joshajohnson/voyager-logic/README.md

# Voyager Logic

A FX3 based logic analyser capable of 16 channels at 100 MSPS.
