joshajohnson/voyager-logic/hardware/0.1/voyager-logic.kicad_pcb

## KiCad design hardware/0.1/voyager-logic.kicad_pcb (2022-12-25)

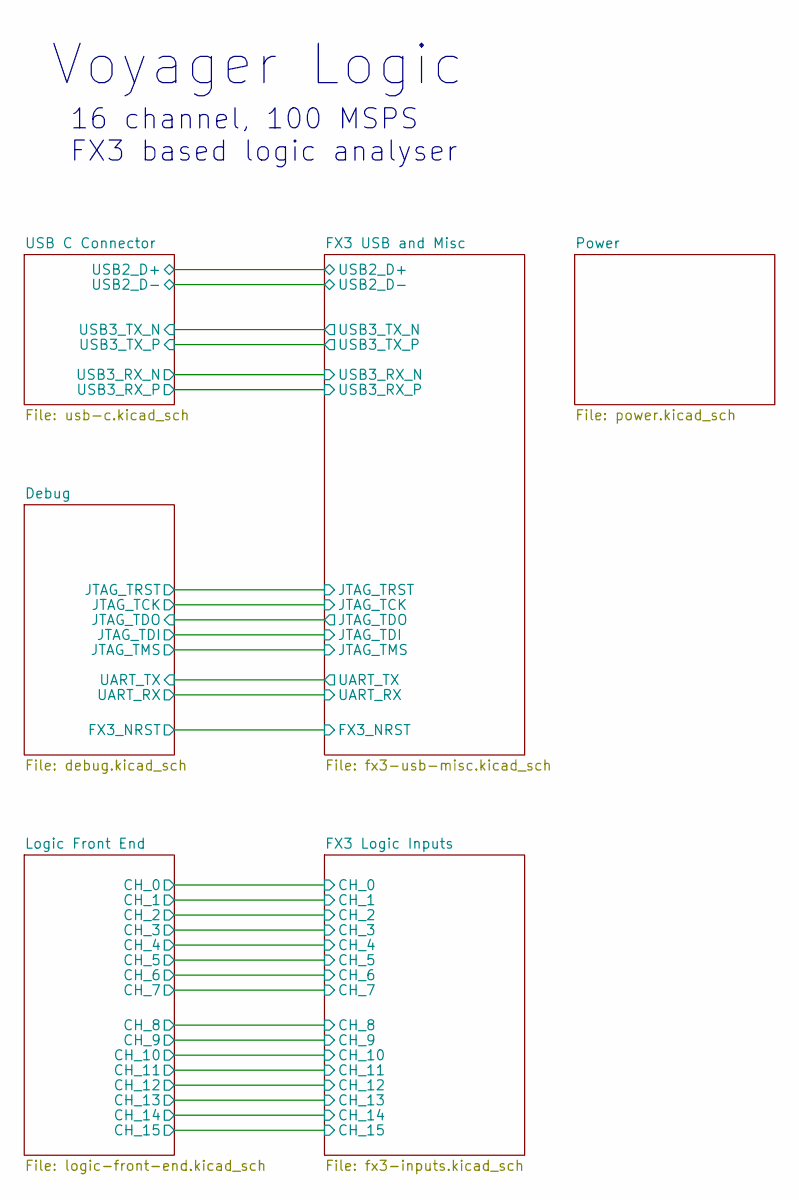
[picture p1: schematic voyager-logic.kicad_sch, Voyager Logic]

Notes on the sheet:
16 channel, 100 MSPS FX3 based logic analyser
Voyager Logic

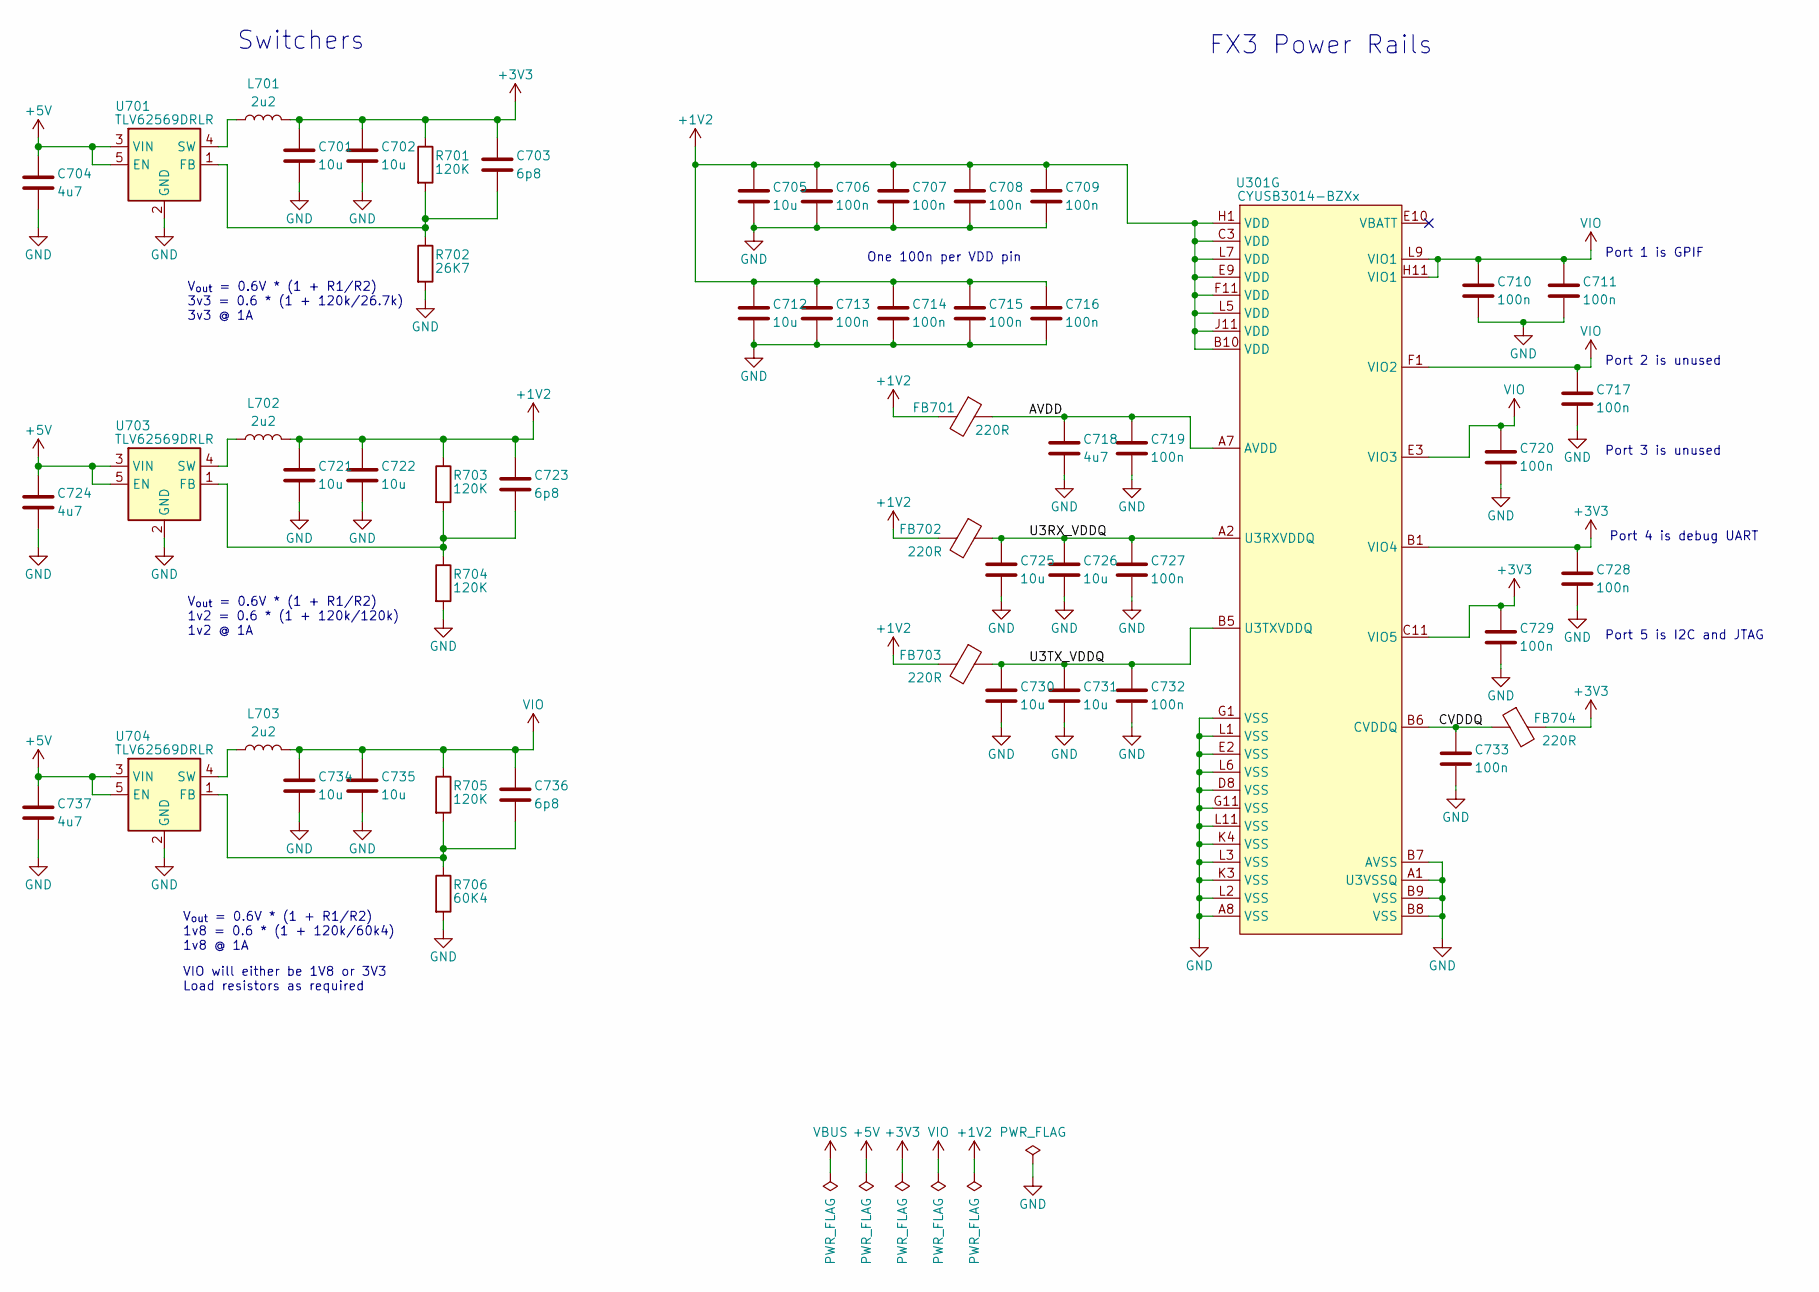
[picture p2: schematic power.kicad_sch, Voyager Logic]

Parts:
C701, C702, C705, C712, C721, C722, C725, C726, C730, C731, C734, C735: 10u; C_0603_1608Metric; MPN CL10A106MA8NRNC; LCSC C96446
C703, C723, C736: 6p8; C_0402_1005Metric; MPN GJM1555C1H6R8BB01D; LCSC C88896
C704, C718, C724, C737: 4u7; C_0402_1005Metric; MPN CL05A475MP5NRNC; LCSC C23733
C706, C707, C708, C709, C710, C711, C713, C714, C715, C716, C717, C719, C720, C727, C728, C729, C732, C733: 100n; C_0402_1005Metric; MPN CL05B104KB54PNC; LCSC C307331
FB701, FB702, FB703, FB704: 220R; R_0402_1005Metric; MPN BLM15PX221SN1D; LCSC C160973
L701, L702, L703: 2u2; L_0805_2012Metric; MPN LQM21PN2R2NGCD; LCSC C216156
R701, R703, R704, R705: 120K; R_0402_1005Metric; MPN RC0402FR-07120KL; LCSC C93945
R702: 26K7; R_0402_1005Metric; MPN RC0402FR-0726K7L; LCSC C138023
R706: 60K4; R_0402_1005Metric; MPN RC0402FR-0760K4L; LCSC C327333
U301: CYUSB3014-BZXx; BGA-121_10x10mm_Layout11x11_P0.8mm; MPN CYUSB3014-BZXC; LCSC C462526
U701, U703, U704: TLV62569DRLR; SOT-563; MPN TLV62569DRLR; LCSC C163217

Connections:
+1V2: C705.1, C706.1, C707.1, C708.1, C709.1, C712.1, C713.1, C714.1, C715.1, C716.1, C721.1, C722.1, C723.1, FB701.2, FB702.2, FB703.2, L702.2, R703.1, U301.B10 (VDD), U301.C3 (VDD), U301.E9 (VDD), U301.F11 (VDD), U301.H1 (VDD), U301.J11 (VDD), U301.L5 (VDD), U301.L7 (VDD)
+3V3: C701.1, C702.1, C703.1, C728.1, C729.1, FB704.2, L701.2, R701.1, U301.B1 (VIO4), U301.C11 (VIO5); also elsewhere on the board
+5V: C704.1, C724.1, C737.1, U701.3 (VIN), U701.5 (EN), U703.3 (VIN), U703.5 (EN), U704.3 (VIN), U704.5 (EN); also elsewhere on the board
/Power/AVDD: C718.1, C719.1, FB701.1, U301.A7 (AVDD)
/Power/CVDDQ: C733.1, FB704.1, U301.B6 (CVDDQ)
/Power/U3RX_VDDQ: C725.1, C726.1, C727.1, FB702.1, U301.A2 (U3RXVDDQ)
/Power/U3TX_VDDQ: C730.1, C731.1, C732.1, FB703.1, U301.B5 (U3TXVDDQ)
GND: C701.2, C702.2, C704.2, C705.2, C706.2, C707.2, C708.2, C709.2, C710.2, C711.2, C712.2, C713.2, C714.2, C715.2, C716.2, C717.2, C718.2, C719.2, C720.2, C721.2, C722.2, C724.2, C725.2, C726.2, C727.2, C728.2, C729.2, C730.2, C731.2, C732.2, C733.2, C734.2, C735.2, C737.2, R702.2, R704.2, R706.2, U301.A1 (U3VSSQ), U301.A8 (VSS), U301.B7 (AVSS), U301.B8 (VSS), U301.B9 (VSS), U301.D8 (VSS), U301.E2 (VSS), U301.G1 (VSS), U301.G11 (VSS), U301.K3 (VSS), U301.K4 (VSS), U301.L1 (VSS), U301.L2 (VSS), U301.L3 (VSS), U301.L6 (VSS), U301.L11 (VSS), U701.2 (GND), U703.2 (GND), U704.2 (GND); also elsewhere on the board
unnamed: C703.2, R701.2, R702.1, U701.1 (FB)
unnamed: C723.2, R703.2, R704.1, U703.1 (FB)
unnamed: C736.2, R705.2, R706.1, U704.1 (FB)
unnamed: L701.1, U701.4 (SW)
unnamed: L702.1, U703.4 (SW)
unnamed: L703.1, U704.4 (SW)
VIO: C710.1, C711.1, C717.1, C720.1, C734.1, C735.1, C736.1, L703.2, R705.1, U301.E3 (VIO3), U301.F1 (VIO2), U301.H11 (VIO1), U301.L9 (VIO1); also elsewhere on the board

Notes on the sheet:
V_{out} = 0.6V * (1 + R1/R2) 3v3 = 0.6 * (1 + 120k/26.7k) 3v3 @ 1A
V_{out} = 0.6V * (1 + R1/R2) 1v8 = 0.6 * (1 + 120k/60k4) 1v8 @ 1A
Switchers
FX3 Power Rails
Port 2 is unused
Port 4 is debug UART
One 100n per VDD pin
Port 3 is unused
V_{out} = 0.6V * (1 + R1/R2) 1v2 = 0.6 * (1 + 120k/120k) 1v2 @ 1A
Port 1 is GPIF
Port 5 is I2C and JTAG
VIO will either be 1V8 or 3V3 Load resistors as required

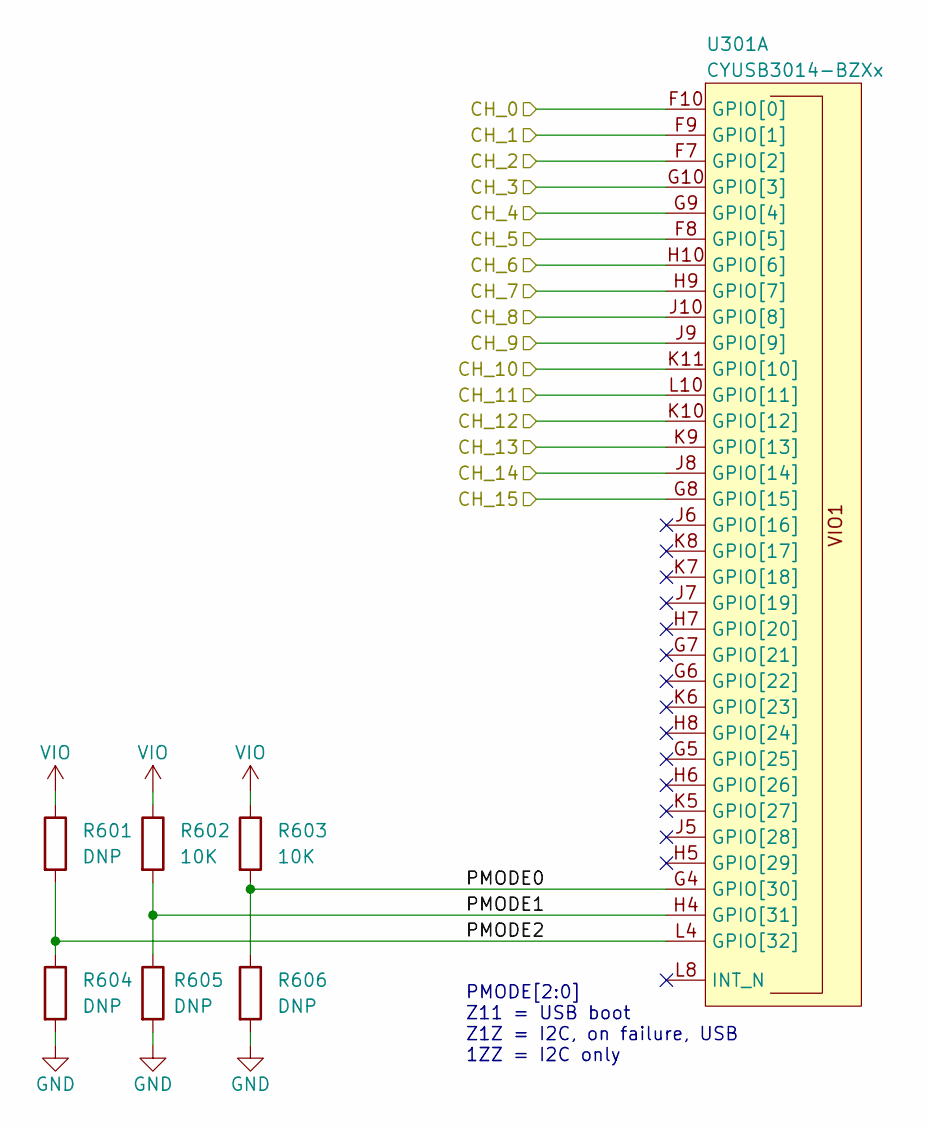
[picture p3: schematic fx3-inputs.kicad_sch, Voyager Logic]

Parts:
R601, R604, R605, R606: DNP; R_0402_1005Metric
R602, R603: 10K; R_0402_1005Metric; MPN RC0402FR-0710KL; LCSC C60490
U301: CYUSB3014-BZXx; BGA-121_10x10mm_Layout11x11_P0.8mm; MPN CYUSB3014-BZXC; LCSC C462526

Connections:
/FX3 Logic Inputs/CH_0: U301.F10 (GPIO[0]); also elsewhere on the board
/FX3 Logic Inputs/CH_1: U301.F9 (GPIO[1]); also elsewhere on the board
/FX3 Logic Inputs/CH_2: U301.F7 (GPIO[2]); also elsewhere on the board
/FX3 Logic Inputs/CH_3: U301.G10 (GPIO[3]); also elsewhere on the board
/FX3 Logic Inputs/CH_4: U301.G9 (GPIO[4]); also elsewhere on the board
/FX3 Logic Inputs/CH_5: U301.F8 (GPIO[5]); also elsewhere on the board
/FX3 Logic Inputs/CH_6: U301.H10 (GPIO[6]); also elsewhere on the board
/FX3 Logic Inputs/CH_7: U301.H9 (GPIO[7]); also elsewhere on the board
/FX3 Logic Inputs/CH_8: U301.J10 (GPIO[8]); also elsewhere on the board
/FX3 Logic Inputs/CH_9: U301.J9 (GPIO[9]); also elsewhere on the board
/FX3 Logic Inputs/CH_10: U301.K11 (GPIO[10]); also elsewhere on the board
/FX3 Logic Inputs/CH_11: U301.L10 (GPIO[11]); also elsewhere on the board
/FX3 Logic Inputs/CH_12: U301.K10 (GPIO[12]); also elsewhere on the board
/FX3 Logic Inputs/CH_13: U301.K9 (GPIO[13]); also elsewhere on the board
/FX3 Logic Inputs/CH_14: U301.J8 (GPIO[14]); also elsewhere on the board
/FX3 Logic Inputs/CH_15: U301.G8 (GPIO[15]); also elsewhere on the board
/FX3 Logic Inputs/PMODE0: R603.2, R606.1, U301.G4 (GPIO[30])
/FX3 Logic Inputs/PMODE1: R602.2, R605.1, U301.H4 (GPIO[31])
/FX3 Logic Inputs/PMODE2: R601.2, R604.1, U301.L4 (GPIO[32])
GND: R604.2, R605.2, R606.2; also elsewhere on the board
VIO: R601.1, R602.1, R603.1; also elsewhere on the board

Notes on the sheet:
PMODE[2:0] Z11 = USB boot Z1Z = I2C, on failure, USB 1ZZ = I2C only

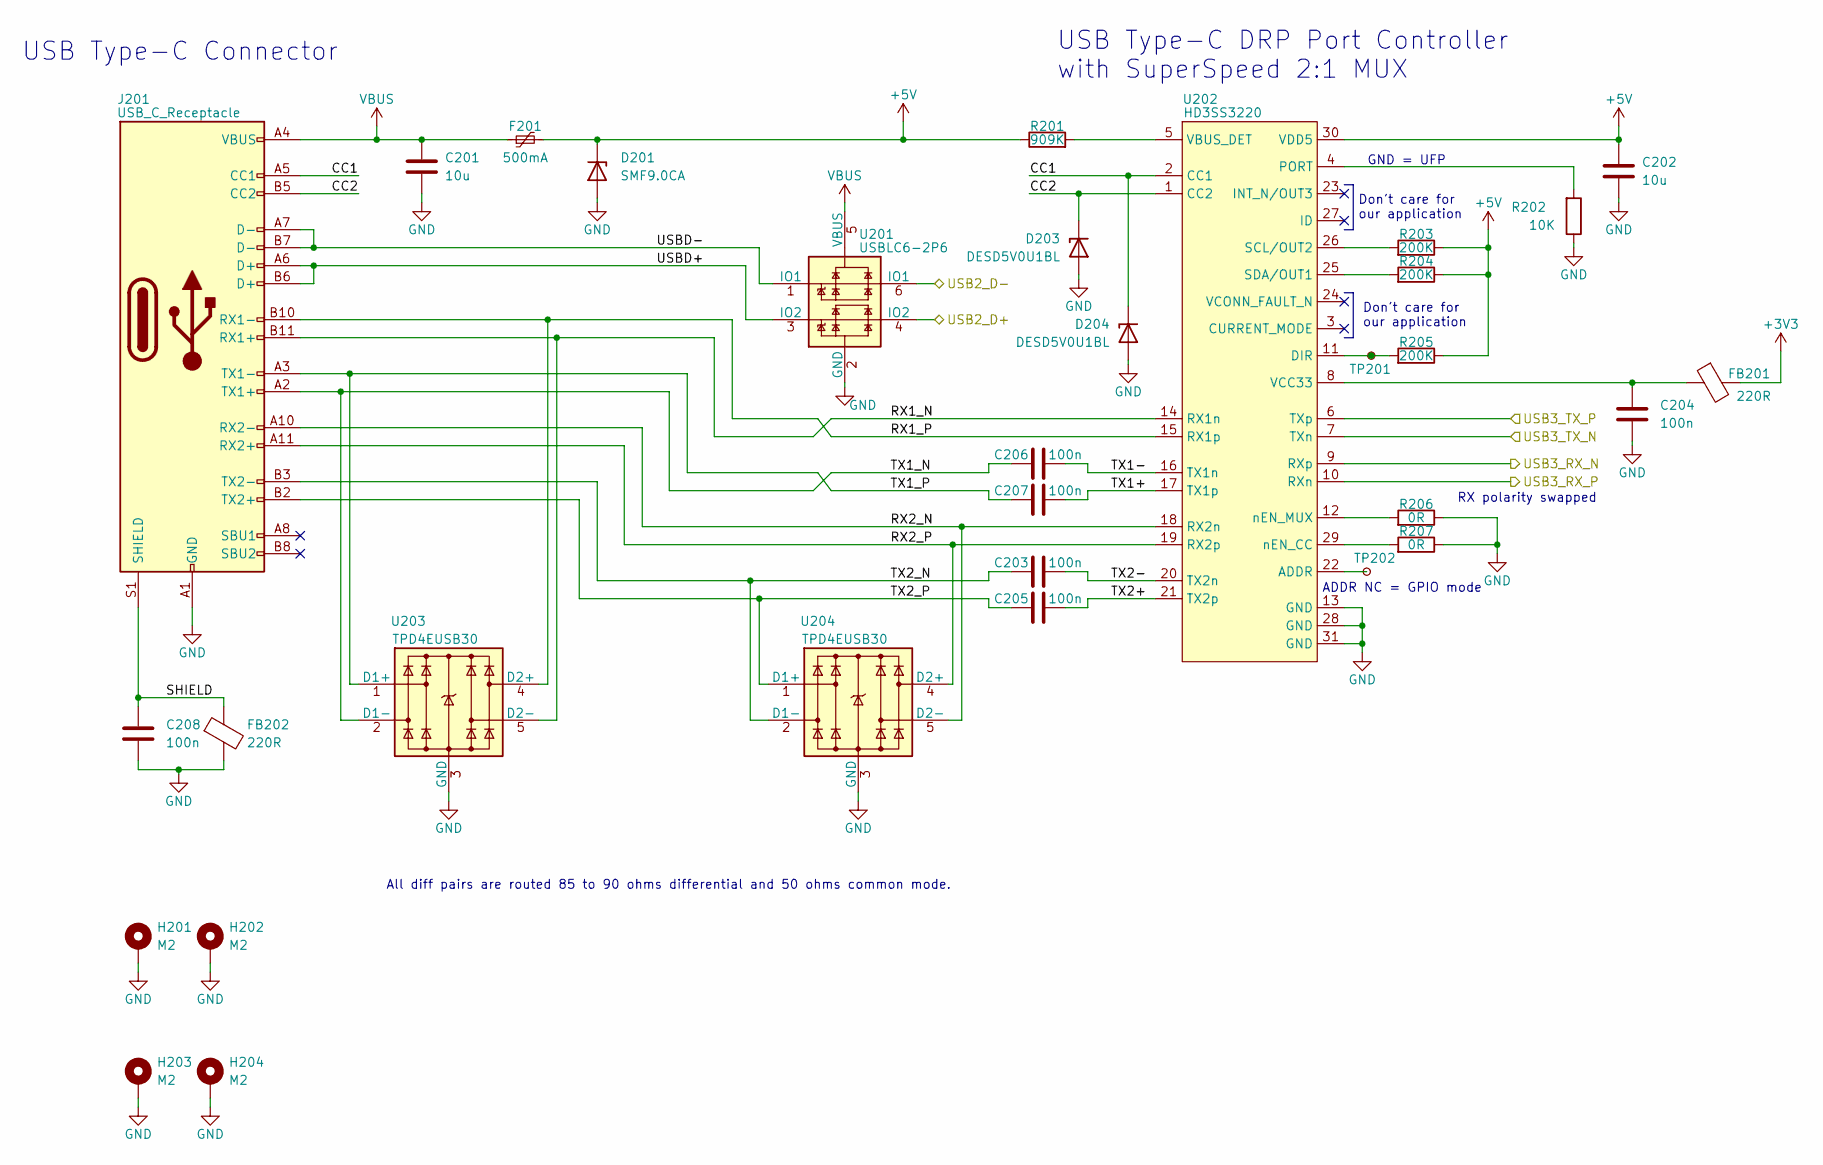
[picture p4: schematic usb-c.kicad_sch, Voyager Logic]

Parts:
C201, C202: 10u; C_0603_1608Metric; MPN CL10A106MA8NRNC; LCSC C96446
C203, C205, C206, C207: 100n; C_0201_0603Metric; MPN CL03A104KO3NNNC; LCSC C307380
C204, C208: 100n; C_0402_1005Metric; MPN CL05B104KB54PNC; LCSC C307331
D201: SMF9.0CA; D_SOD-123FL; MPN SMF9.0CA; Digikey 18-SMF9.0CACT-ND
D203, D204: DESD5V0U1BL; D_X1-DFN1006-2; MPN DESD5V0U1BL-7B; Digikey 31-DESD5V0U1BL-7BCT-ND
F201: 500mA; Fuse_0805_2012Metric; MPN SMD0805-050; LCSC C66452
FB201, FB202: 220R; R_0402_1005Metric; MPN BLM15PX221SN1D; LCSC C160973
H201, H202, H203, H204: M2; MountingHole_2.2mm_M2_ISO7380_Pad
J201: USB_C_Receptacle; USB_C_Receptacle_Amphenol_10137062-00021LF; MPN 10137062-00021LF; Digikey 609-6109-1-ND
R201: 909K; R_0402_1005Metric; MPN AC0402FR-07909KL; LCSC C227267
R202: 10K; R_0402_1005Metric; MPN RC0402FR-0710KL; LCSC C60490
R203, R204, R205: 200K; R_0402_1005Metric; MPN RC0402FR-07200KL; LCSC C114763
R206, R207: 0R; R_0402_1005Metric; MPN RC0402FR-070RL; LCSC C106231
TP201, TP202: TP; TestPoint_SMDPad_D0.5mm_NO_SILK
U201: USBLC6-2P6; SOT-563; MPN USBLC6-2P6; LCSC C15999
U202: HD3SS3220; Texas_RNH0030A_WQFN-30_2.5x4.5mm_P0.4mm; MPN HD3SS3220RN; Digikey 296-48293-1-ND
U203, U204: TPD4EUSB30; USON-10_2.5x1.0mm_P0.5mm; MPN TPD4EUSB30DQAR; Digikey 296-28063-1-ND

Connections:
+3V3: FB201.2; also elsewhere on the board
+5V: C202.1, D201.1 (K), F201.2, R201.1, R203.1, R204.1, R205.1, U202.30 (VDD5); also elsewhere on the board
/FX3 USB and Misc/USB2_D+: U201.4 (IO2); also elsewhere on the board
/FX3 USB and Misc/USB2_D-: U201.6 (IO1); also elsewhere on the board
/FX3 USB and Misc/USB3_RX_N: U202.9 (RXp); also elsewhere on the board
/FX3 USB and Misc/USB3_RX_P: U202.10 (RXn); also elsewhere on the board
/FX3 USB and Misc/USB3_TX_N: U202.7 (TXn); also elsewhere on the board
/FX3 USB and Misc/USB3_TX_P: U202.6 (TXp); also elsewhere on the board
/USB C Connector/CC1: D204.1 (K), J201.A5 (CC1), U202.2 (CC1)
/USB C Connector/CC2: D203.1 (K), J201.B5 (CC2), U202.1 (CC2)
/USB C Connector/RX1_N: J201.B11 (RX1+), U202.14 (RX1n), U203.5 (D2-), U203.6 (NC)
/USB C Connector/RX1_P: J201.B10 (RX1-), U202.15 (RX1p), U203.4 (D2+), U203.7 (NC)
/USB C Connector/RX2_N: J201.A10 (RX2-), U202.18 (RX2n), U204.5 (D2-), U204.6 (NC)
/USB C Connector/RX2_P: J201.A11 (RX2+), U202.19 (RX2p), U204.4 (D2+), U204.7 (NC)
/USB C Connector/SHIELD: C208.1, FB202.1, J201.S1 (SHIELD)
/USB C Connector/TX1+: C207.2, U202.17 (TX1p)
/USB C Connector/TX1-: C206.2, U202.16 (TX1n)
/USB C Connector/TX1_N: C206.1, J201.A2 (TX1+), U203.2 (D1-), U203.9 (NC)
/USB C Connector/TX1_P: C207.1, J201.A3 (TX1-), U203.1 (D1+), U203.10 (NC)
/USB C Connector/TX2+: C205.2, U202.21 (TX2p)
/USB C Connector/TX2-: C203.2, U202.20 (TX2n)
/USB C Connector/TX2_N: C203.1, J201.B3 (TX2-), U204.2 (D1-), U204.9 (NC)
/USB C Connector/TX2_P: C205.1, J201.B2 (TX2+), U204.1 (D1+), U204.10 (NC)
/USB C Connector/USBD+: J201.A6 (D+), J201.B6 (D+), U201.3 (IO2)
/USB C Connector/USBD-: J201.A7 (D-), J201.B7 (D-), U201.1 (IO1)
GND: C201.2, C202.2, C204.2, C208.2, D201.2 (A), D203.2 (A), D204.2 (A), FB202.2, H201.1, H202.1, H203.1, H204.1, J201.A1 (GND), J201.A12 (GND), J201.B1 (GND), J201.B12 (GND), R202.1, R206.1, R207.1, U201.2 (GND), U202.13 (GND), U202.28 (GND), U202.31 (GND), U203.3 (GND), U203.8 (GND), U204.3 (GND), U204.8 (GND); also elsewhere on the board
unnamed: C204.1, FB201.1, U202.8 (VCC33)
unnamed: R201.2, U202.5 (VBUS_DET)
unnamed: R202.2, U202.4 (PORT)
unnamed: R203.2, U202.26 (SCL/OUT2)
unnamed: R204.2, U202.25 (SDA/OUT1)
unnamed: R205.2, TP201.1, U202.11 (DIR)
unnamed: R206.2, U202.12 (nEN_MUX)
unnamed: R207.2, U202.29 (nEN_CC)
unnamed: TP202.1, U202.22 (ADDR)
VBUS: C201.1, F201.1, J201.A4 (VBUS), J201.A9 (VBUS), J201.B4 (VBUS), J201.B9 (VBUS), U201.5 (VBUS)

Notes on the sheet:
Don't care for our application
RX polarity swapped
ADDR NC = GPIO mode
GND = UFP
USB Type-C Connector
All diff pairs are routed 85 to 90 ohms differential and 50 ohms common mode.
USB Type-C DRP Port Controller with SuperSpeed 2:1 MUX

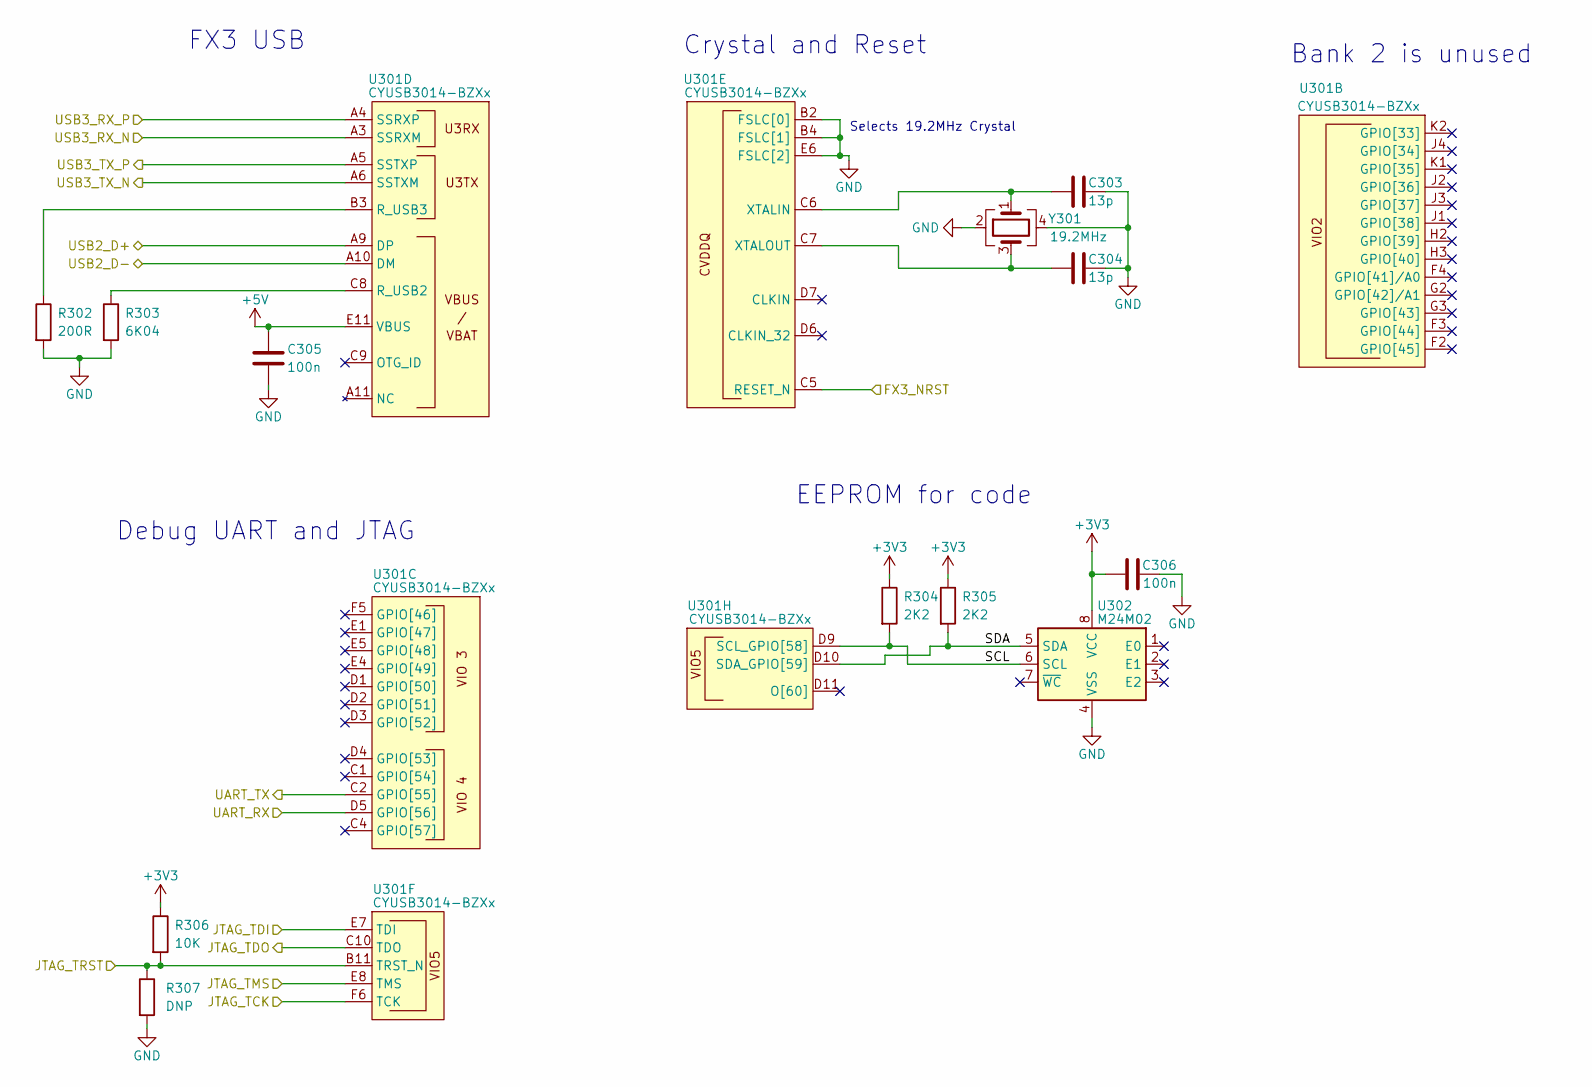
[picture p5: schematic fx3-usb-misc.kicad_sch, Voyager Logic]

Parts:
C303, C304: 13p; C_0402_1005Metric; MPN GCM1555C1H130JA16D; LCSC C2195053
C305, C306: 100n; C_0402_1005Metric; MPN CL05B104KB54PNC; LCSC C307331
R302: 200R; R_0402_1005Metric; MPN RC0402FR-07200RL; LCSC C114764
R303: 6K04; R_0402_1005Metric; MPN AC0402FR-076K04L; LCSC C144739
R304, R305: 2K2; R_0402_1005Metric; MPN RC0402FR-072K2L; LCSC C114762
R306: 10K; R_0402_1005Metric; MPN RC0402FR-0710KL; LCSC C60490
R307: DNP; R_0402_1005Metric
U301: CYUSB3014-BZXx; BGA-121_10x10mm_Layout11x11_P0.8mm; MPN CYUSB3014-BZXC; LCSC C462526
U302: M24M02; SOIC-8_3.9x4.9mm_P1.27mm; MPN M24M02-DRMN6TP; LCSC C115042
Y301: 19.2MHz; Crystal_SMD_2520-4Pin_2.5x2.0mm; MPN EXS00A-CS05400; Digikey 644-1162-2-ND

Connections:
+3V3: C306.1, R304.1, R305.1, R306.1, U302.8 (VCC); also elsewhere on the board
+5V: C305.1, U301.E11 (VBUS); also elsewhere on the board
/Debug/FX3_NRST: U301.C5 (RESET_N); also elsewhere on the board
/Debug/JTAG_TCK: U301.F6 (TCK); also elsewhere on the board
/Debug/JTAG_TDI: U301.E7 (TDI); also elsewhere on the board
/Debug/JTAG_TDO: U301.C10 (TDO); also elsewhere on the board
/Debug/JTAG_TMS: U301.E8 (TMS); also elsewhere on the board
/Debug/JTAG_TRST: R306.2, R307.1, U301.B11 (TRST_N); also elsewhere on the board
/Debug/UART_RX: U301.D5 (GPIO[56]); also elsewhere on the board
/Debug/UART_TX: U301.C2 (GPIO[55]); also elsewhere on the board
/FX3 USB and Misc/SCL: R304.2, U301.D9 (SCL_GPIO[58]), U302.6 (SCL)
/FX3 USB and Misc/SDA: R305.2, U301.D10 (SDA_GPIO[59]), U302.5 (SDA)
/FX3 USB and Misc/USB2_D+: U301.A9 (DP); also elsewhere on the board
/FX3 USB and Misc/USB2_D-: U301.A10 (DM); also elsewhere on the board
/FX3 USB and Misc/USB3_RX_N: U301.A3 (SSRXM); also elsewhere on the board
/FX3 USB and Misc/USB3_RX_P: U301.A4 (SSRXP); also elsewhere on the board
/FX3 USB and Misc/USB3_TX_N: U301.A6 (SSTXM); also elsewhere on the board
/FX3 USB and Misc/USB3_TX_P: U301.A5 (SSTXP); also elsewhere on the board
GND: C303.2, C304.2, C305.2, C306.2, R302.2, R303.2, R307.2, U301.B2 (FSLC[0]), U301.B4 (FSLC[1]), U301.E6 (FSLC[2]), U302.4 (VSS), Y301.2, Y301.4; also elsewhere on the board
unnamed: C303.1, U301.C6 (XTALIN), Y301.1
unnamed: C304.1, U301.C7 (XTALOUT), Y301.3
unnamed: R302.1, U301.B3 (R_USB3)
unnamed: R303.1, U301.C8 (R_USB2)

Notes on the sheet:
Crystal and Reset
Selects 19.2MHz Crystal
FX3 USB
Debug UART and JTAG
EEPROM for code
Bank 2 is unused

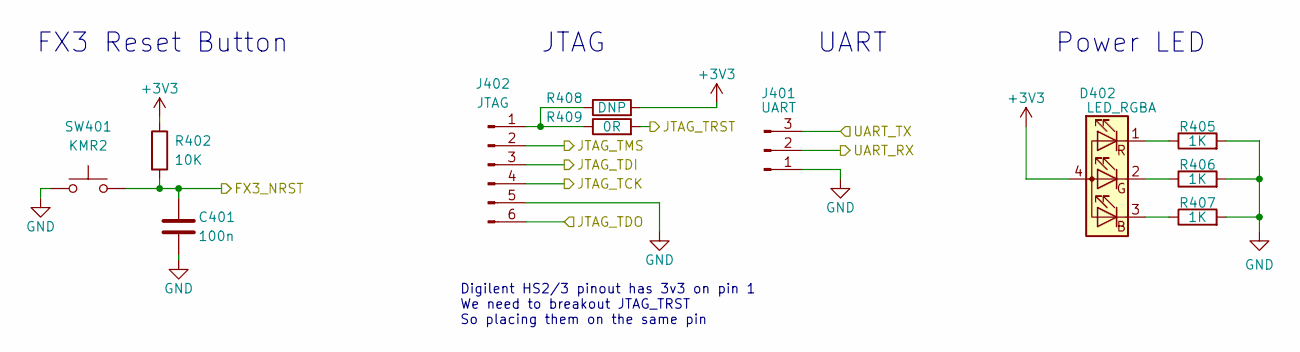
[picture p6: schematic debug.kicad_sch, Voyager Logic]

Parts:
C401: 100n; C_0402_1005Metric; MPN CL05B104KB54PNC; LCSC C307331
D402: LED_RGBA; LED_TRI_2020; MPN FM-B2020RGBA-HG; LCSC C108793
J401: UART; 3_PIN_THT_Staggered
J402: JTAG; 6_PIN_THT_Staggered
R402: 10K; R_0402_1005Metric; MPN RC0402FR-0710KL; LCSC C60490
R405, R406, R407: 1K; R_0402_1005Metric; MPN AC0402FR-071KL; LCSC C144789
R408: DNP; R_0402_1005Metric
R409: 0R; R_0402_1005Metric; MPN RC0402FR-070RL; LCSC C106231
SW401: KMR2; SW_Push_KMR2; MPN KMR233GLFG; LCSC C2689601

Connections:
+3V3: D402.4 (A), R402.1, R408.2; also elsewhere on the board
/Debug/FX3_NRST: C401.1, R402.2, SW401.2; also elsewhere on the board
/Debug/JTAG_TCK: J402.4; also elsewhere on the board
/Debug/JTAG_TDI: J402.3; also elsewhere on the board
/Debug/JTAG_TDO: J402.6; also elsewhere on the board
/Debug/JTAG_TMS: J402.2; also elsewhere on the board
/Debug/JTAG_TRST: R409.2; also elsewhere on the board
/Debug/UART_RX: J401.2; also elsewhere on the board
/Debug/UART_TX: J401.3; also elsewhere on the board
GND: C401.2, J401.1, J402.5, R405.2, R406.2, R407.2, SW401.1; also elsewhere on the board
unnamed: D402.1 (RK), R405.1
unnamed: D402.2 (GK), R406.1
unnamed: D402.3 (BK), R407.1
unnamed: J402.1, R408.1, R409.1

Notes on the sheet:
Power LED
UART
Digilent HS2/3 pinout has 3v3 on pin 1 We need to breakout JTAG_TRST So placing them on the same pin
FX3 Reset Button
JTAG

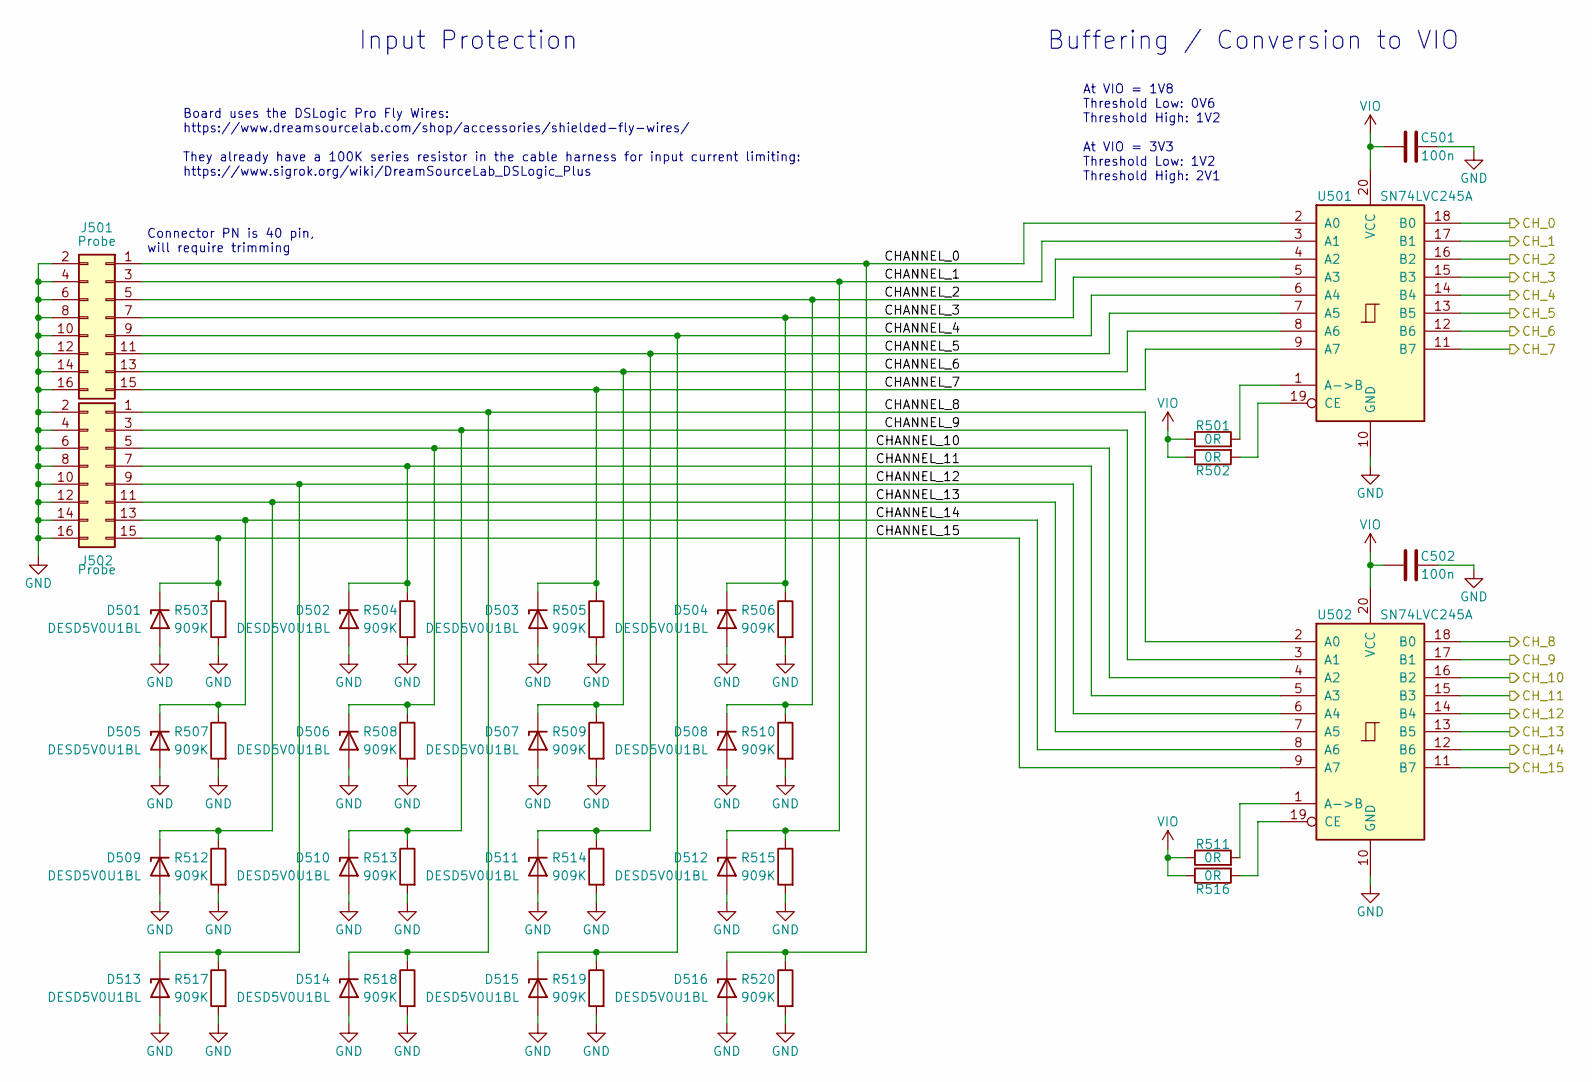
[picture p7: schematic logic-front-end.kicad_sch, Voyager Logic]

Parts:
C501, C502: 100n; C_0402_1005Metric; MPN CL05B104KB54PNC; LCSC C307331
D501, D502, D503, D504, D505, D506, D507, D508, D509, D510, D511, D512, D513, D514, D515, D516: DESD5V0U1BL; D_X1-DFN1006-2; MPN DESD5V0U1BL-7B; Digikey 31-DESD5V0U1BL-7BCT-ND
J501, J502: Probe; PinSocket_2x08_P1.27mm_Horizontal
R501, R502, R511, R516: 0R; R_0402_1005Metric; MPN RC0402FR-070RL; LCSC C106231
R503, R504, R505, R506, R507, R508, R509, R510, R512, R513, R514, R515, R517, R518, R519, R520: 909K; R_0402_1005Metric; MPN AC0402FR-07909KL; LCSC C227267
U501, U502: SN74LVC245A; TSSOP-20_4.4x6.5mm_P0.65mm; MPN SN74LVC245ARGYR; Digikey SN74LVC245ARGYR

Connections:
/FX3 Logic Inputs/CH_0: U501.18 (B0); also elsewhere on the board
/FX3 Logic Inputs/CH_1: U501.17 (B1); also elsewhere on the board
/FX3 Logic Inputs/CH_2: U501.16 (B2); also elsewhere on the board
/FX3 Logic Inputs/CH_3: U501.15 (B3); also elsewhere on the board
/FX3 Logic Inputs/CH_4: U501.14 (B4); also elsewhere on the board
/FX3 Logic Inputs/CH_5: U501.13 (B5); also elsewhere on the board
/FX3 Logic Inputs/CH_6: U501.12 (B6); also elsewhere on the board
/FX3 Logic Inputs/CH_7: U501.11 (B7); also elsewhere on the board
/FX3 Logic Inputs/CH_8: U502.18 (B0); also elsewhere on the board
/FX3 Logic Inputs/CH_9: U502.17 (B1); also elsewhere on the board
/FX3 Logic Inputs/CH_10: U502.16 (B2); also elsewhere on the board
/FX3 Logic Inputs/CH_11: U502.15 (B3); also elsewhere on the board
/FX3 Logic Inputs/CH_12: U502.14 (B4); also elsewhere on the board
/FX3 Logic Inputs/CH_13: U502.13 (B5); also elsewhere on the board
/FX3 Logic Inputs/CH_14: U502.12 (B6); also elsewhere on the board
/FX3 Logic Inputs/CH_15: U502.11 (B7); also elsewhere on the board
/Logic Front End/CHANNEL_0: D516.1 (K), J501.1, R520.1, U501.2 (A0)
/Logic Front End/CHANNEL_1: D512.1 (K), J501.3, R515.1, U501.3 (A1)
/Logic Front End/CHANNEL_2: D508.1 (K), J501.5, R510.1, U501.4 (A2)
/Logic Front End/CHANNEL_3: D504.1 (K), J501.7, R506.1, U501.5 (A3)
/Logic Front End/CHANNEL_4: D515.1 (K), J501.9, R519.1, U501.6 (A4)
/Logic Front End/CHANNEL_5: D511.1 (K), J501.11, R514.1, U501.7 (A5)
/Logic Front End/CHANNEL_6: D507.1 (K), J501.13, R509.1, U501.8 (A6)
/Logic Front End/CHANNEL_7: D503.1 (K), J501.15, R505.1, U501.9 (A7)
/Logic Front End/CHANNEL_8: D514.1 (K), J502.1, R518.1, U502.2 (A0)
/Logic Front End/CHANNEL_9: D510.1 (K), J502.3, R513.1, U502.3 (A1)
/Logic Front End/CHANNEL_10: D506.1 (K), J502.5, R508.1, U502.4 (A2)
/Logic Front End/CHANNEL_11: D502.1 (K), J502.7, R504.1, U502.5 (A3)
/Logic Front End/CHANNEL_12: D513.1 (K), J502.9, R517.1, U502.6 (A4)
/Logic Front End/CHANNEL_13: D509.1 (K), J502.11, R512.1, U502.7 (A5)
/Logic Front End/CHANNEL_14: D505.1 (K), J502.13, R507.1, U502.8 (A6)
/Logic Front End/CHANNEL_15: D501.1 (K), J502.15, R503.1, U502.9 (A7)
GND: C501.2, C502.2, D501.2 (A), D502.2 (A), D503.2 (A), D504.2 (A), D505.2 (A), D506.2 (A), D507.2 (A), D508.2 (A), D509.2 (A), D510.2 (A), D511.2 (A), D512.2 (A), D513.2 (A), D514.2 (A), D515.2 (A), D516.2 (A), J501.2, J501.4, J501.6, J501.8, J501.10, J501.12, J501.14, J501.16, J502.2, J502.4, J502.6, J502.8, J502.10, J502.12, J502.14, J502.16, R503.2, R504.2, R505.2, R506.2, R507.2, R508.2, R509.2, R510.2, R512.2, R513.2, R514.2, R515.2, R517.2, R518.2, R519.2, R520.2, U501.10 (GND), U502.10 (GND); also elsewhere on the board
unnamed: R501.2, U501.1 (A->B)
unnamed: R502.2, U501.19 (CE)
unnamed: R511.2, U502.1 (A->B)
unnamed: R516.2, U502.19 (CE)
VIO: C501.1, C502.1, R501.1, R502.1, R511.1, R516.1, U501.20 (VCC), U502.20 (VCC); also elsewhere on the board

Notes on the sheet:
Buffering / Conversion to VIO
Board uses the DSLogic Pro Fly Wires: https://www.dreamsourcelab.com/shop/accessories/shielded-fly-wires/ They already have a 100K series resistor in the cable harness for input current limiting: https://www.sigrok.org/wiki/DreamSourceLab_DSLogic_Plus
Connector PN is 40 pin, will require trimming
At VIO = 1V8 Threshold Low: 0V6 Threshold High: 1V2 At VIO = 3V3 Threshold Low: 1V2 Threshold High: 2V1
Input Protection

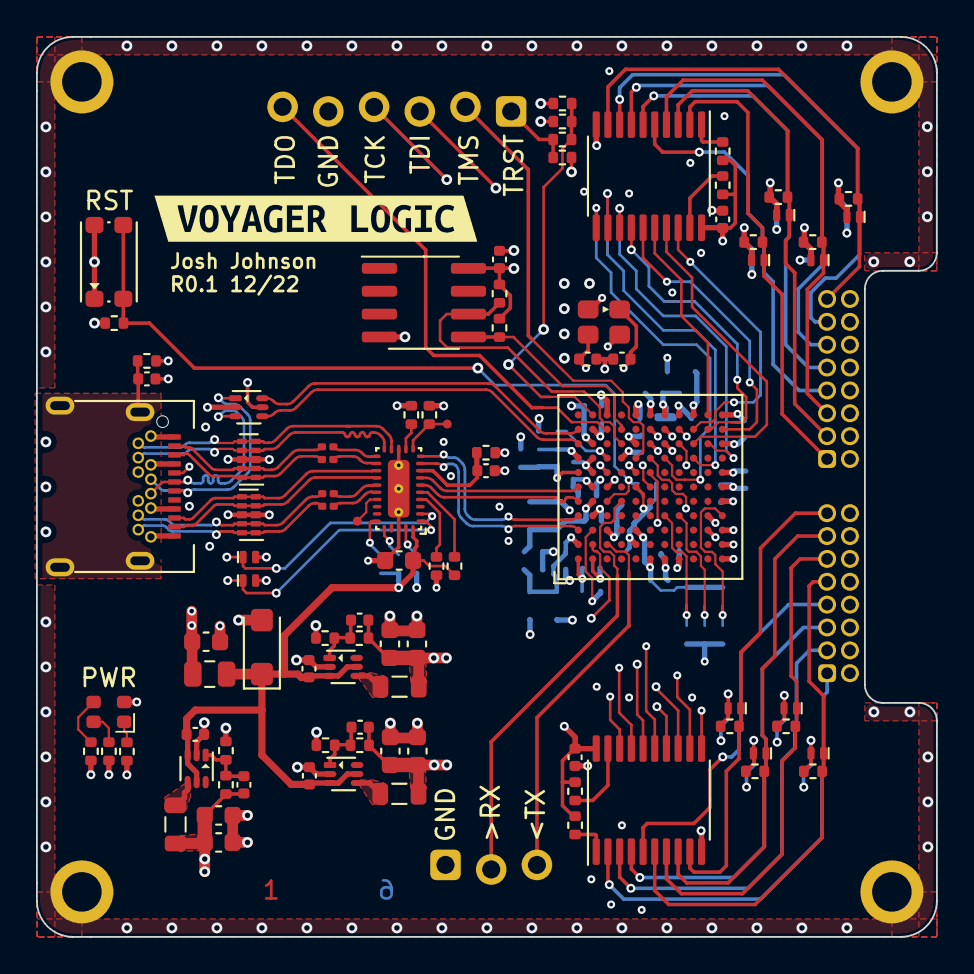
[picture p8: board voyager-logic.kicad_pcb from above]

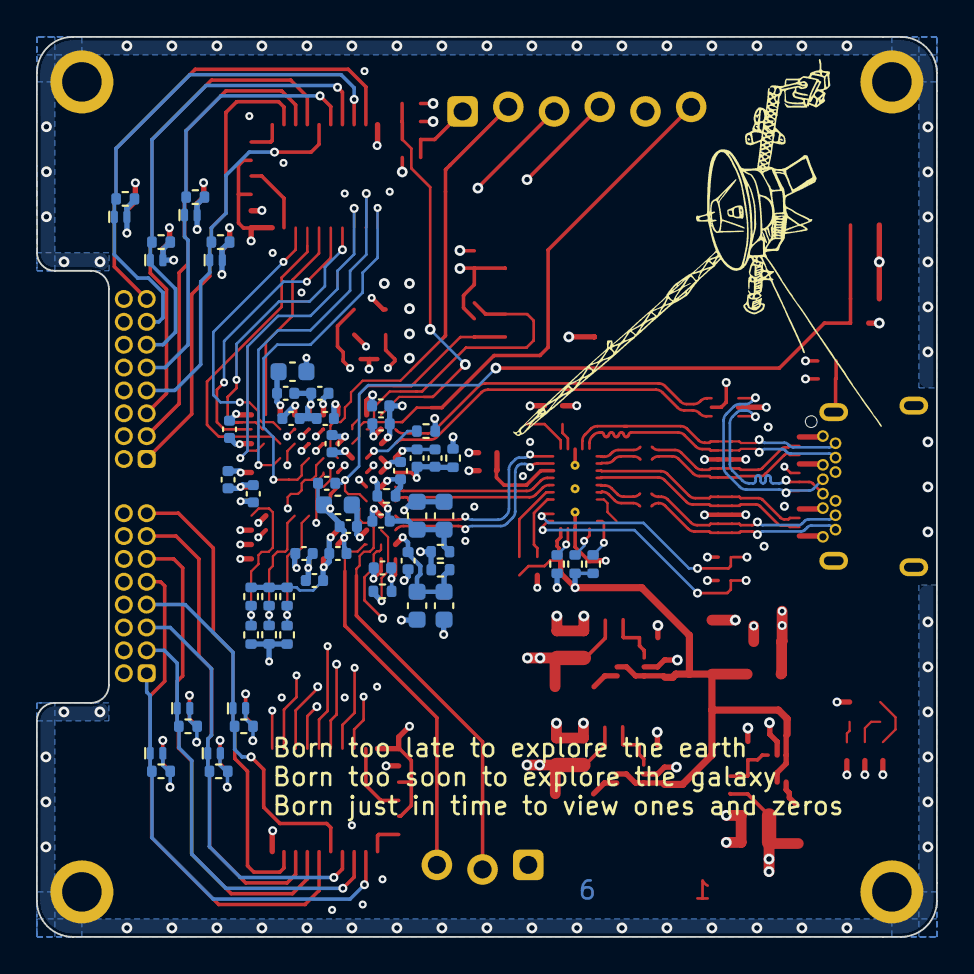
[picture p9: board voyager-logic.kicad_pcb from below]

Board: 6 copper layers, 50.0 x 50.0 mm, 158 parts (58 on the bottom side), 105 nets.

Other parts of the board:
kibuzzard-63948718: G***; kibuzzard-63948718
