joshajohnson/voyager-logic/(threads)

Thread 1 (2022-11-22):

More than 16 channels?

brainstorm, 2022-11-22:
I have a FX3 super speed dev board and I was wondering if the GPIF can be configured to get more than 16 channels?

/cc @projectgus

joshajohnson, 2022-11-22:
That's a great quesion Roman.

The goal of this project is more or less to clone the [logic analyser example](https://community.infineon.com/t5/Knowledge-Base-Articles/EZ-USB-FX3-Explorer-kit-as-16-channel-100-MHz-logic-analyzer-with-sigrok/ta-p/283993) but with Type-C to get some experience with USB 3 layout / 6 layer boards etc, so I haven't looked into the code too much.

However the GPIF of the CYUSB3014 is 32 bits wide and as per the comments of the project it's being DMA'd over to USB so there might be a chance?

```
  This is a sample application that demonstrates data transfer from the FX3 GPIF port to the
  USB port.

  The application makes use a simple GPIF configuration which continually latches the state
  of the GPIF data pins and fills them into full data packets to be sent to the USB host through
  a BULK-IN endpoint. The GPIF configuration and DMA data path are setup to facilitate the fastest
  possible data transfer.
```

Thread 2 (2025-06-22):

0.1 Assembly Notes

joshajohnson, 2025-06-22:
- D201 should be SMF5.0.
- Connector pinout is incorrect - there is a one col space between connectors. As such you can not plug two debug leads next to each other.
- Power LED doesn't work - need to investigate.
- R603 is removed after initial programming. Should be able to DNP from the start as I2C will fail (blank EEPROM) and fallback to USB.
- Too much solder on the DFN TVS diodes - they float during assembly.
