joshajohnson/voyager-logic/(commit log)

2022-11-22 setup template
    [voyager-logic.kicad_pcb, voyager-logic.kicad_sch]
2022-11-24 wip usb c design
    [usb-c.kicad_sch, voyager-logic.kicad_sch]
2022-11-25 continue schematic design
    [debug.kicad_sch, fx3-usb-misc.kicad_sch, power.kicad_sch, usb-c.kicad_sch, voyager-logic.kicad_sch]
2022-11-26 first pass schematic done
    [debug.kicad_sch, fx3-inputs.kicad_sch, fx3-usb-misc.kicad_sch, logic-front-end.kicad_sch, power.kicad_sch, usb-c.kicad_sch, voyager-logic.kicad_sch]
2022-11-27 finalise BOM
    [debug.kicad_sch, fx3-usb-misc.kicad_sch, logic-front-end.kicad_sch, power.kicad_sch, usb-c.kicad_sch, voyager-logic.kicad_pcb, voyager-logic.kicad_sch]
2022-11-29 all components fit inside outline
    [debug.kicad_sch, fx3-usb-misc.kicad_sch, logic-front-end.kicad_sch, power.kicad_sch, voyager-logic.kicad_pcb, voyager-logic.kicad_sch]
2022-12-05 break out bga
    [debug.kicad_sch, fx3-inputs.kicad_sch, fx3-usb-misc.kicad_sch, usb-c.kicad_sch, voyager-logic.kicad_pcb, voyager-logic.kicad_sch]
2022-12-06 more io routing
    [voyager-logic.kicad_pcb, voyager-logic.kicad_sch]
2022-12-10 usb3 routed less tuning
    [debug.kicad_sch, power.kicad_sch, usb-c.kicad_sch, voyager-logic.kicad_pcb, voyager-logic.kicad_sch]
2022-12-10 wip, switchers todo
    [debug.kicad_sch, usb-c.kicad_sch, voyager-logic.kicad_pcb, voyager-logic.kicad_sch]
2022-12-11 erc = drc = 0, fixup BOM
    [debug.kicad_sch, fx3-inputs.kicad_sch, fx3-usb-misc.kicad_sch, logic-front-end.kicad_sch, usb-c.kicad_sch, voyager-logic.kicad_pcb, voyager-logic.kicad_sch]
2022-12-21 component shortage changes
    [debug.kicad_sch, fx3-usb-misc.kicad_sch, logic-front-end.kicad_sch, power.kicad_sch, usb-c.kicad_sch, voyager-logic.kicad_pcb, voyager-logic.kicad_sch]
2022-12-25 clean up everything but usb3
    [voyager-logic.kicad_pcb]
2022-12-25 usb 3 clean up
    [usb-c.kicad_sch, voyager-logic.kicad_pcb, voyager-logic.kicad_sch]
